ichilmioglou/ichos/Hardware/ichos.kicad_pcb

## KiCad design Hardware/ichos.kicad_pcb (2024-10-07)

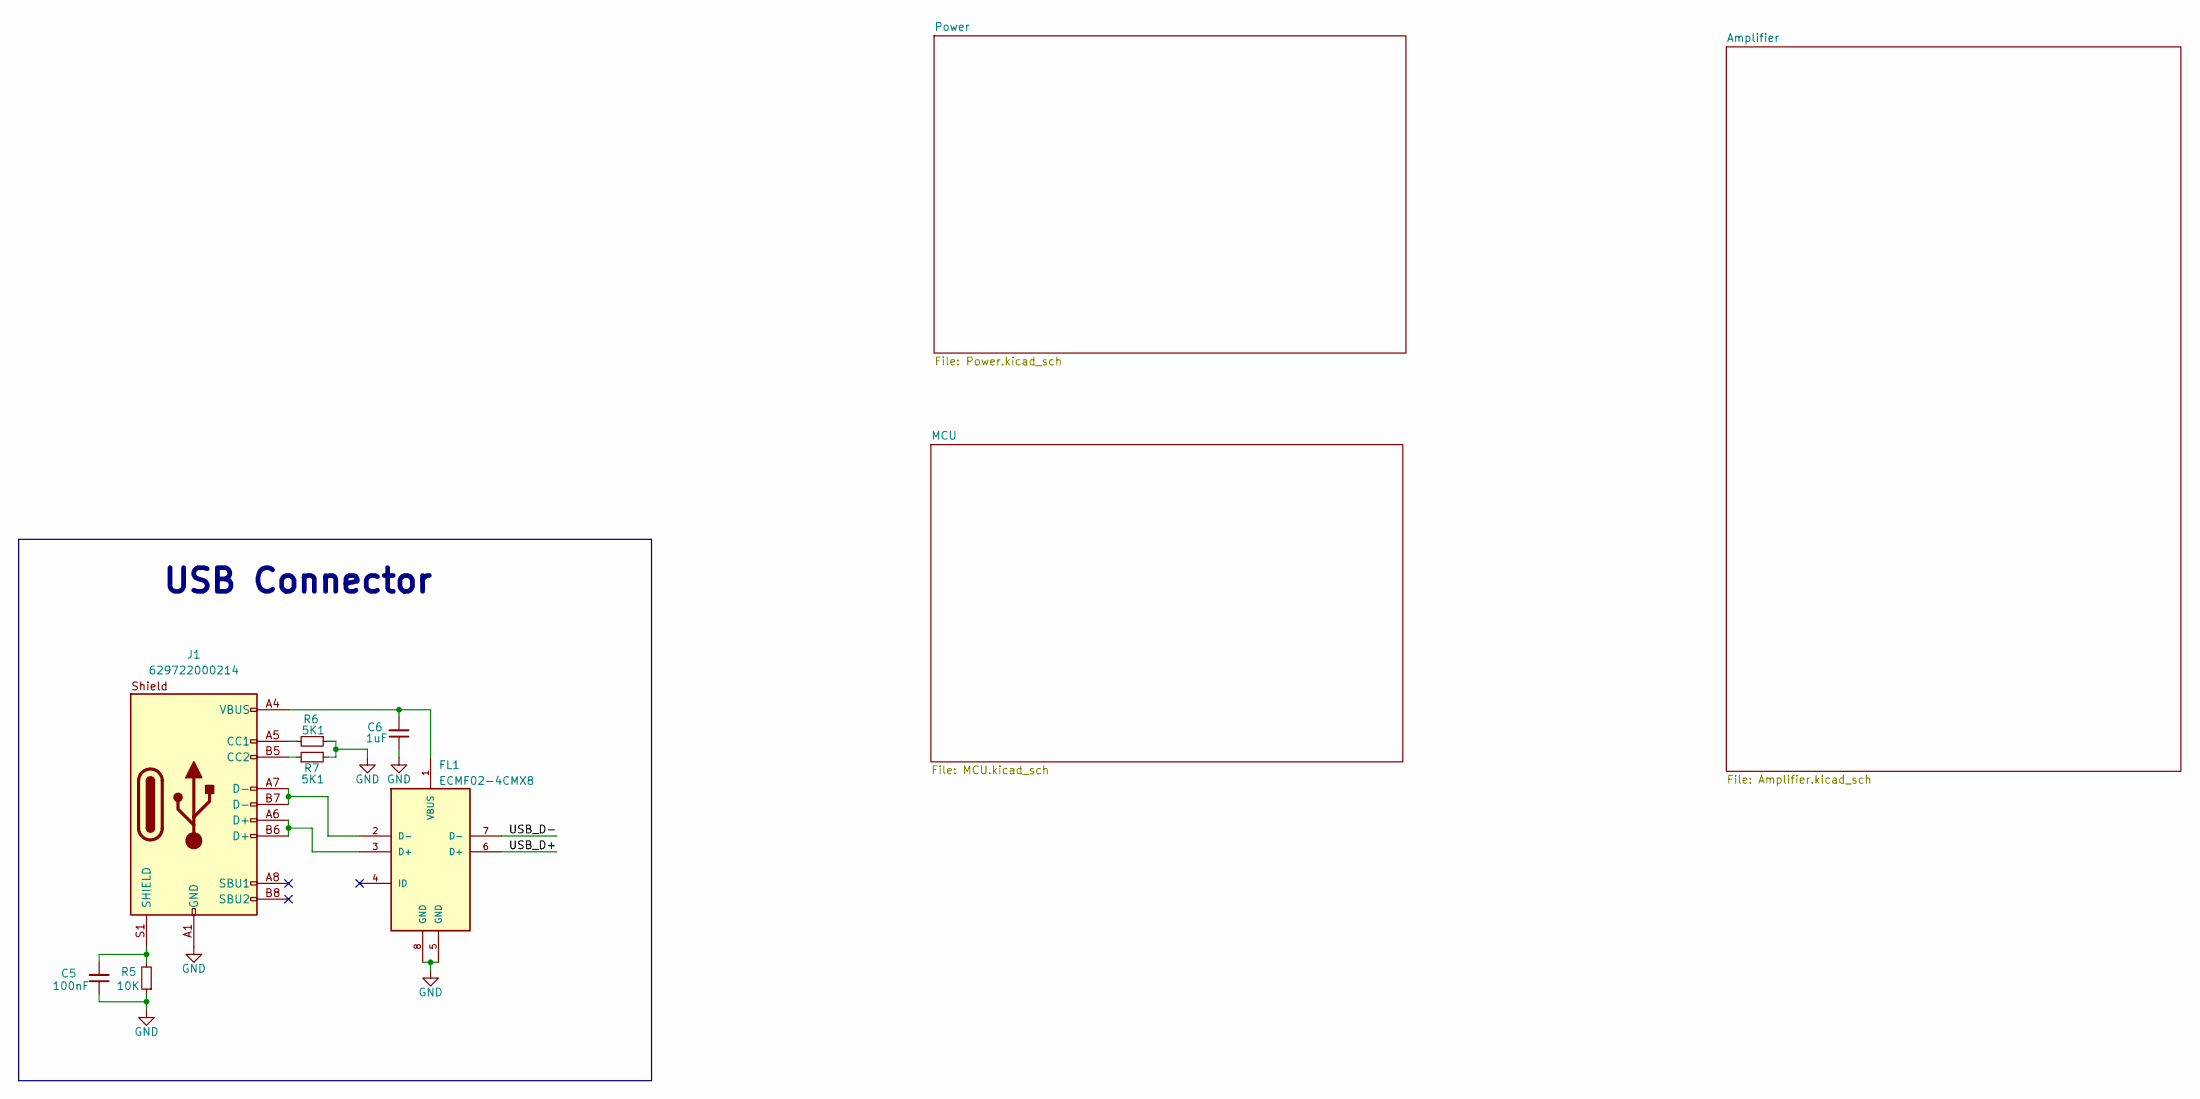
[picture p1: schematic ichos.kicad_sch]

Parts:
C5: 100nF; C_0402_1005Metric; Rating 50VDC 10% X7R
C6: 1uF; C_0603_1608Metric; Rating 50VDC 10% X7R
FL1: ECMF02-4CMX8
J1: 629722000214
R5: 10K; R_0402_1005Metric; Rating 1%
R6, R7: 5K1; R_0402_1005Metric; Rating 1%

Connections:
/USB_D+: FL1.6 (D+)
/USB_D-: FL1.7 (D-)
GND: C5.1, C6.1, FL1.5 (GND), FL1.8 (GND), J1.A1 (GND), J1.A12 (GND), J1.B1 (GND), J1.B12 (GND), R5.1, R6.1, R7.2; also elsewhere on the board
unnamed: FL1.3 (D+), J1.A6 (D+), J1.B6 (D+)
unnamed: FL1.2 (D-), J1.A7 (D-), J1.B7 (D-)
unnamed 26: C6.2, FL1.1 (VBUS), J1.A4 (VBUS), J1.A9 (VBUS), J1.B4 (VBUS), J1.B9 (VBUS); also elsewhere on the board
unnamed: J1.A5 (CC1), R6.2
unnamed: J1.B5 (CC2), R7.1
unnamed: C5.2, J1.S1 (SHIELD), R5.2

Notes on the sheet:
USB Connector

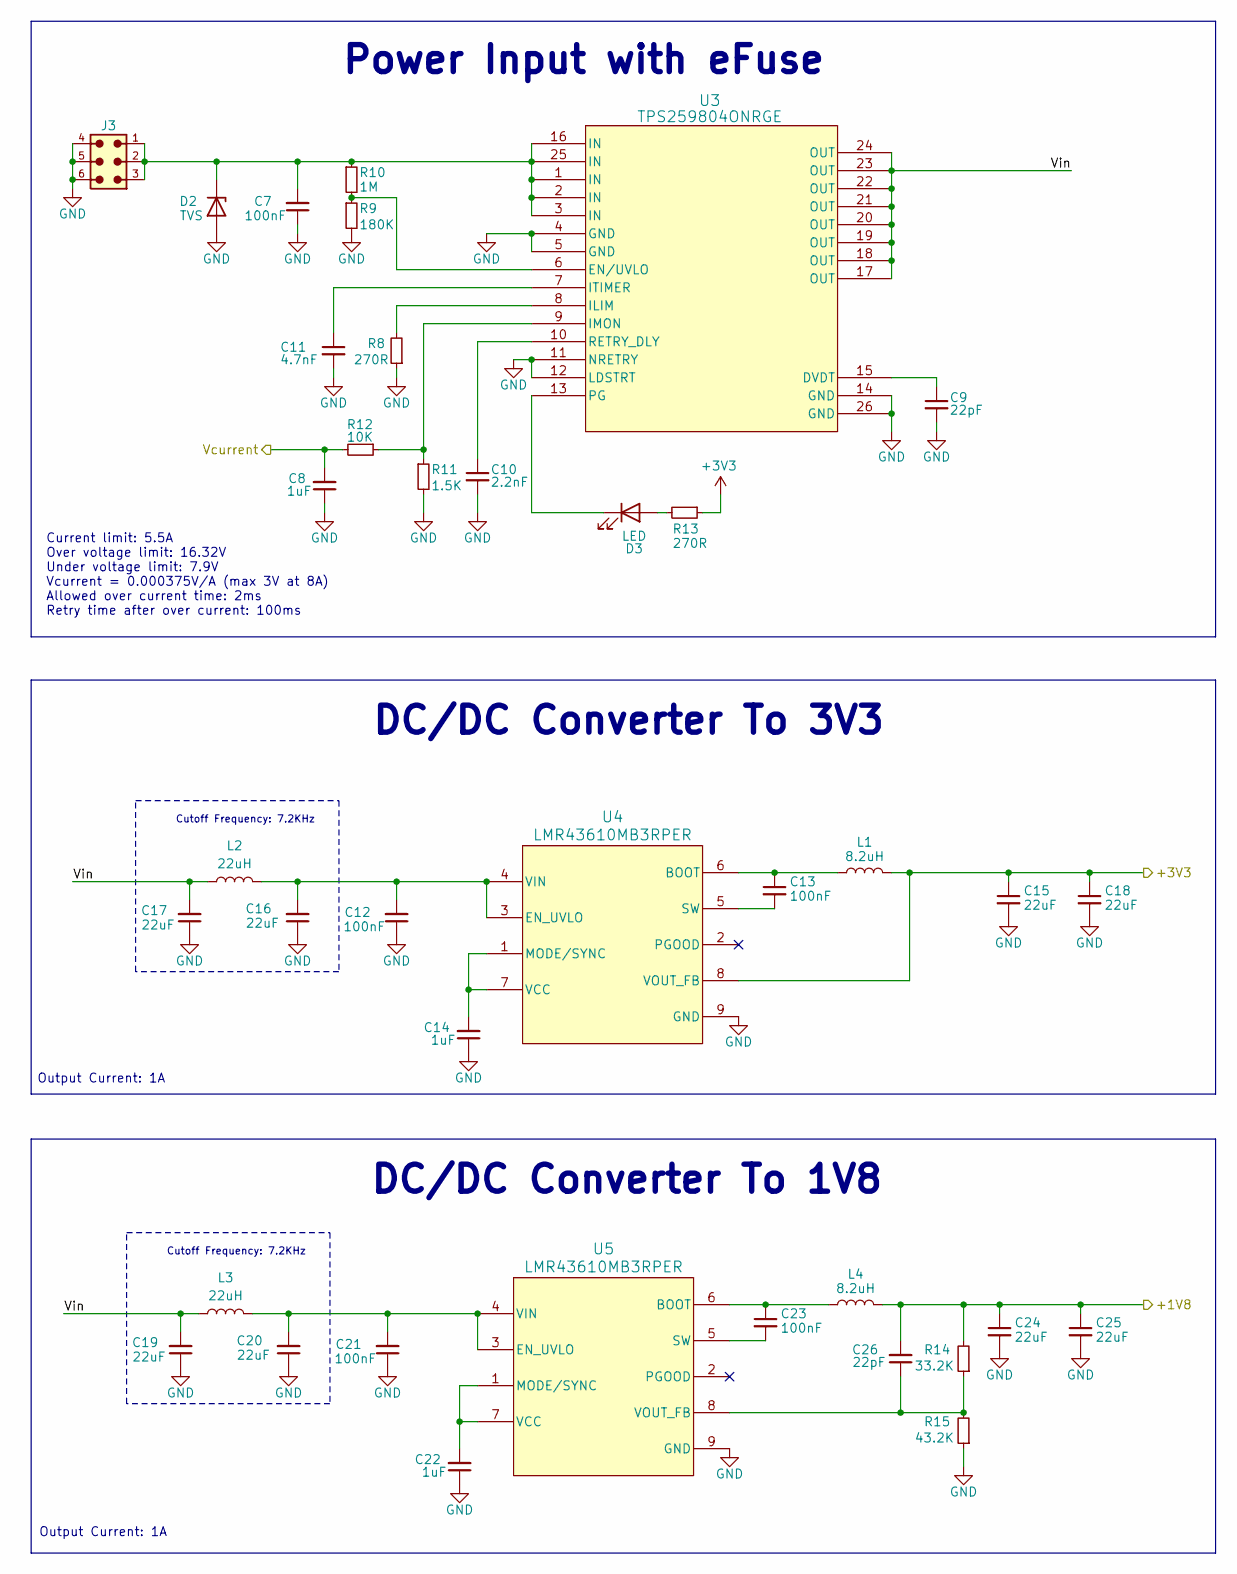
[picture p2: schematic Power.kicad_sch]

Parts:
C7, C12, C13, C21, C23: 100nF; C_0402_1005Metric; Rating 50VDC 10% X7R
C8, C14, C22: 1uF; C_0603_1608Metric; Rating 50VDC 10% X7R
C9, C26: 22pF; C_0402_1005Metric; Rating 100V 2% C0G
C10: 2.2nF; C_0402_1005Metric; Rating 50V 10% X7R
C11: 4.7nF; C_0402_1005Metric; Rating 50V 5% X7R
C15, C16, C17, C18, C19, C20, C24, C25: 22uF; C_1206_3216Metric; Rating 25VDC 10% X7R
D2: 824550121; D_SMC
D3: LED; LED_0603_1608Metric
J3: 64900621122
L1, L4: 8.2uH; 744042008
L2, L3: 22uH; 744053220
R8, R13: 270R; R_0402_1005Metric; Rating 1%
R9: 180K; R_0402_1005Metric; Rating 1%
R10: 1M; R_0402_1005Metric; Rating 1%
R11: 1.5K; R_0402_1005Metric; Rating 1%
R12: 10K; R_0402_1005Metric; Rating 1%
R14: 33.2K; R_0402_1005Metric; Rating 1%
R15: 43.2K; R_0402_1005Metric; Rating 1%
U3: TPS259804ONRGE; TPS259804ONRGER
U4, U5: LMR43610MB3RPER

Connections:
+1V8: C24.1, C25.1, C26.2, L4.2, R14.2; also elsewhere on the board
+3V3: C15.1, C18.1, L1.2, R13.1, U4.8 (VOUT_FB)
/Power/Vcurrent: C8.2, R12.2
/Power/Vin: C17.2, C19.2, L2.1, L3.1, U3.17 (OUT), U3.18 (OUT), U3.19 (OUT), U3.20 (OUT), U3.21 (OUT), U3.22 (OUT), U3.23 (OUT), U3.24 (OUT)
GND: C7.1, C8.1, C9.2, C10.2, C11.2, C12.1, C14.1, C15.2, C16.1, C17.1, C18.2, C19.1, C20.1, C21.1, C22.1, C24.2, C25.2, D2.2 (A), J3.4, J3.5, J3.6, R8.1, R9.2, R11.2, R15.1, U3.4 (GND), U3.5 (GND), U3.11 (NRETRY), U3.12 (LDSTRT), U3.14 (GND), U3.26 (GND), U4.9 (GND), U5.9 (GND); also elsewhere on the board
unnamed 21: C7.2, D2.1 (K), J3.1, J3.2, J3.3, R10.1, U3.1 (IN), U3.2 (IN), U3.3 (IN), U3.16 (IN), U3.25 (IN); also elsewhere on the board
unnamed: D3.2 (A), R13.2
unnamed: D3.1 (K), U3.13 (PG)
unnamed: C9.1, U3.15 (DVDT)
unnamed: R9.1, R10.2, U3.6 (EN/UVLO)
unnamed: R8.2, U3.8 (ILIM)
unnamed: R11.1, R12.1, U3.9 (IMON)
unnamed: C11.1, U3.7 (ITIMER)
unnamed: C10.1, U3.10 (RETRY_DLY)
unnamed: C13.1, L1.1, U4.6 (BOOT)
unnamed: C12.2, C16.2, L2.2, U4.3 (EN_UVLO), U4.4 (VIN)
unnamed: C14.2, U4.1 (MODE/SYNC), U4.7 (VCC)
unnamed: C13.2, U4.5 (SW)
unnamed: C23.1, L4.1, U5.6 (BOOT)
unnamed: C20.2, C21.2, L3.2, U5.3 (EN_UVLO), U5.4 (VIN)
unnamed: C22.2, U5.1 (MODE/SYNC), U5.7 (VCC)
unnamed: C23.2, U5.5 (SW)
unnamed: C26.1, R14.1, R15.2, U5.8 (VOUT_FB)

Notes on the sheet:
Cutoff Frequency: 7.2KHz
DC/DC Converter To 3V3
Output Current: 1A
DC/DC Converter To 1V8
Current limit: 5.5A Over voltage limit: 16.32V Under voltage limit: 7.9V Vcurrent = 0.000375V/A (max 3V at 8A) Allowed over current time: 2ms Retry time after over current: 100ms
Power Input with eFuse

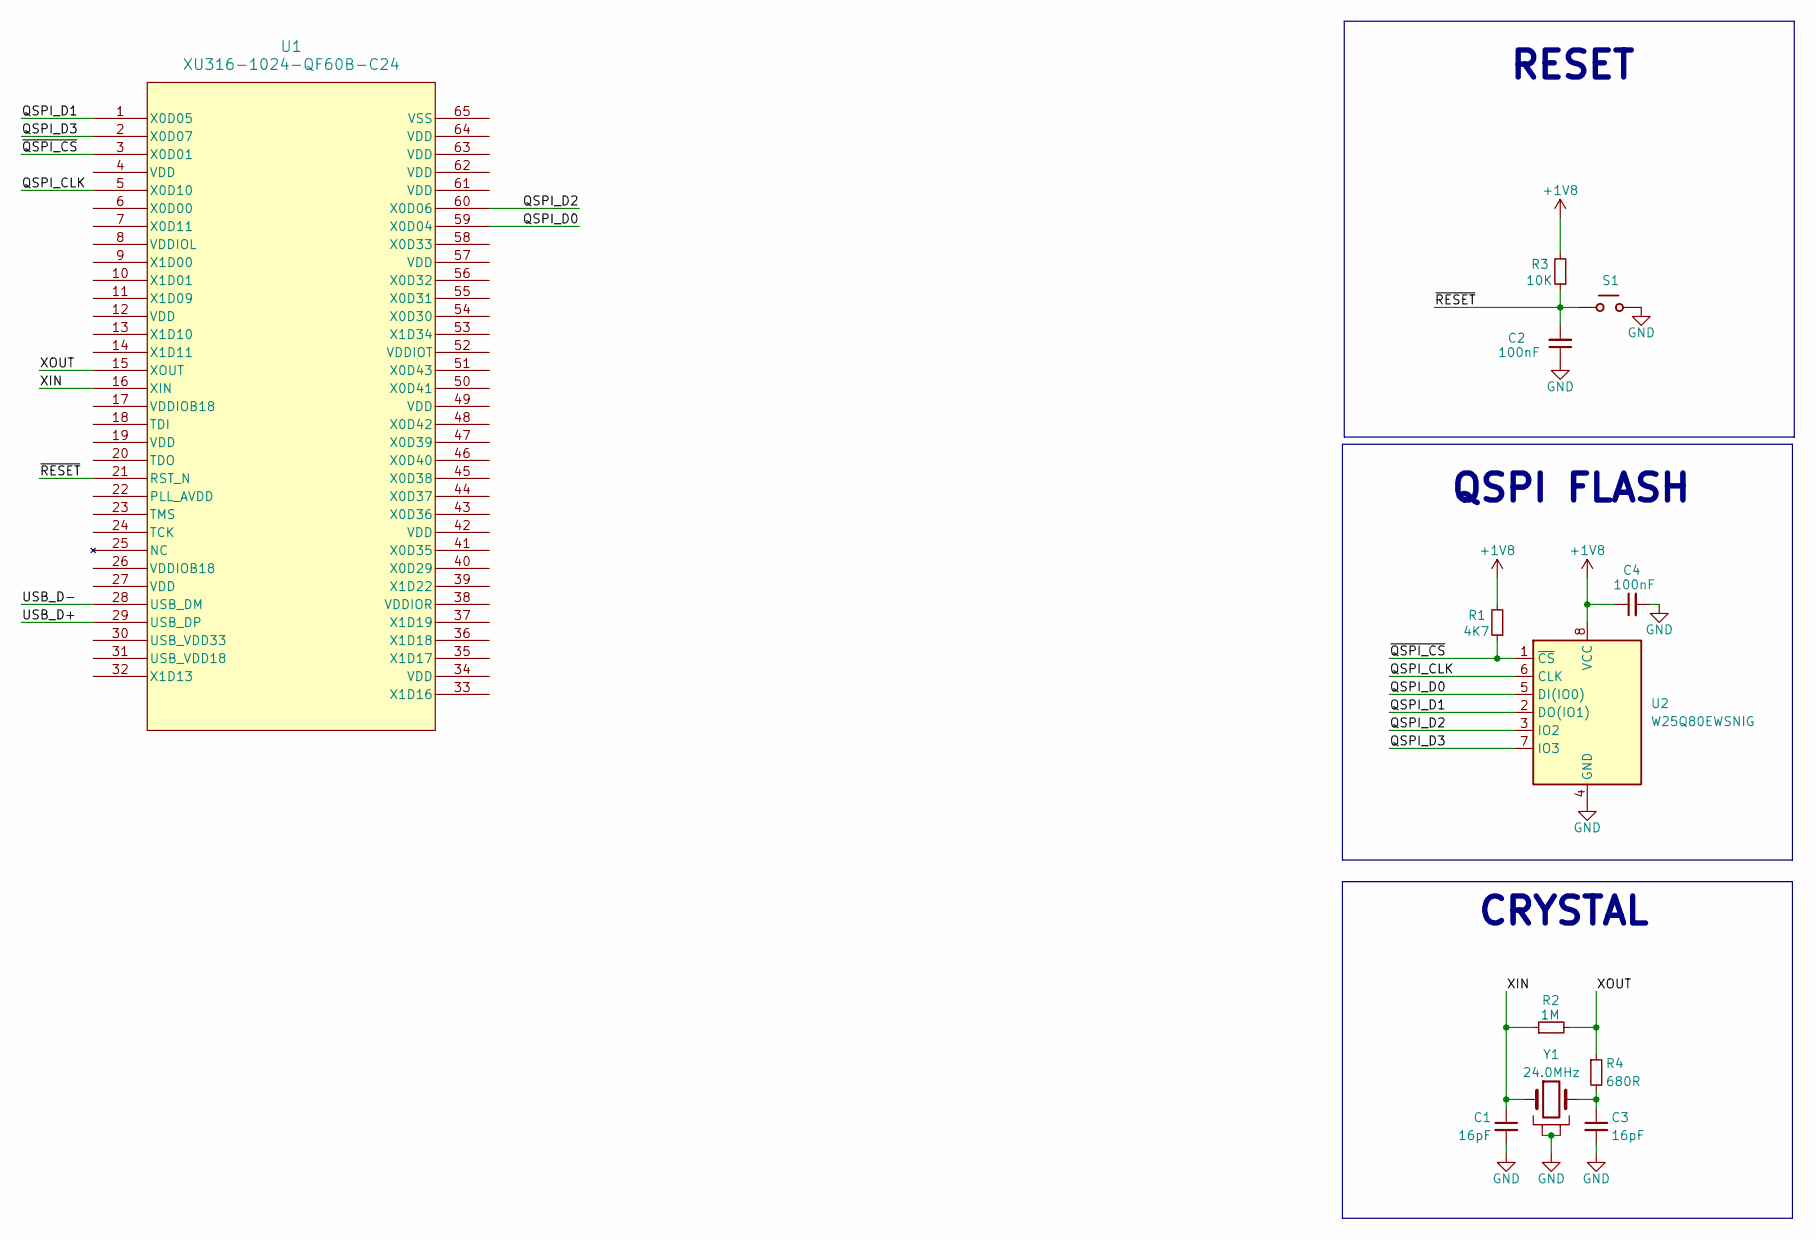
[picture p3: schematic MCU.kicad_sch]

Parts:
C1, C3: 16pF; C_0402_1005Metric; Rating 50VDC 1% C0G
C2, C4: 100nF; C_0402_1005Metric; Rating 50VDC 10% X7R
R1: 4K7; R_0402_1005Metric; Rating 1%
R2: 1M; R_0402_1005Metric; Rating 1%
R3: 10K; R_0402_1005Metric; Rating 1%
R4: 680R; R_0402_1005Metric; Rating 1%
S1: 430481031816
U1: XU316-1024-QF60B-C24; XU316-1024-QF60B-C32
U2: W25Q80EWSNIG; SOIC-8_5.23x5.23mm_P1.27mm
Y1: 24.0MHz; 830108340709

Connections:
+1V8: C4.1, R1.2, R3.2, U2.8 (VCC); also elsewhere on the board
/MCU/QSPI_CLK: U1.5 (X0D10), U2.6 (CLK)
/MCU/QSPI_D0: U1.59 (X0D04), U2.5 (DI(IO0))
/MCU/QSPI_D1: U1.1 (X0D05), U2.2 (DO(IO1))
/MCU/QSPI_D2: U1.60 (X0D06), U2.3 (IO2)
/MCU/QSPI_D3: U1.2 (X0D07), U2.7 (IO3)
/MCU/USB_D+: U1.29 (USB_DP)
/MCU/USB_D-: U1.28 (USB_DM)
/MCU/XIN: C1.1, R2.1, U1.16 (XIN), Y1.1
/MCU/XOUT: R2.2, R4.1, U1.15 (XOUT)
/MCU/~QSPI_CS: R1.1, U1.3 (X0D01), U2.1 (~CS)
/MCU/~RESET: C2.2, R3.1, S1.1, S1.2, U1.21 (RST_N)
GND: C1.2, C2.1, C3.2, C4.2, S1.3, S1.4, U2.4 (GND), Y1.2, Y1.3; also elsewhere on the board
unnamed: C3.1, R4.2, Y1.4

Notes on the sheet:
QSPI FLASH
RESET
CRYSTAL

Board: 2 copper layers, 60 parts (0 on the bottom side), 40 nets, no tracks yet.

Other parts of the board:
D1: SKM14; D_SOD-123F
F1: 0ZCG0035FF2C; Fuse_1812_4532Metric
J2: 691317510002

Their connections:
GND: J2.2; also elsewhere on the board
unnamed: D1.2 (A), F1.2
unnamed 21: J2.1; also elsewhere on the board
unnamed 26: F1.1; also elsewhere on the board
